ForestRupicolous/ESP32-WorkTimeTracker/gehaeuse/vorschau.png

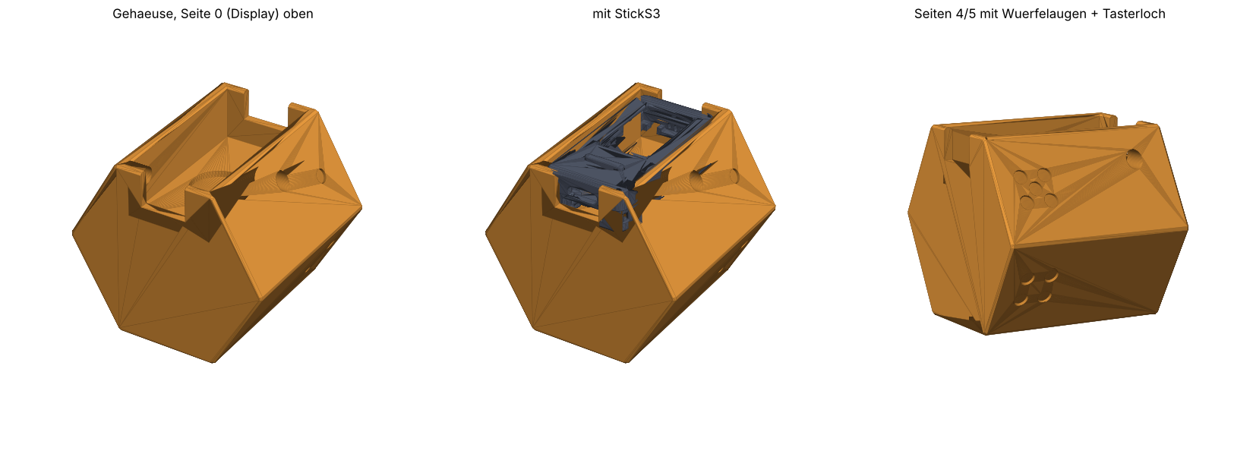
gehaeuse/vorschau.png
