ForestRupicolous/ESP32-WorkTimeTracker/gehaeuse/vorschau_muenze8.png

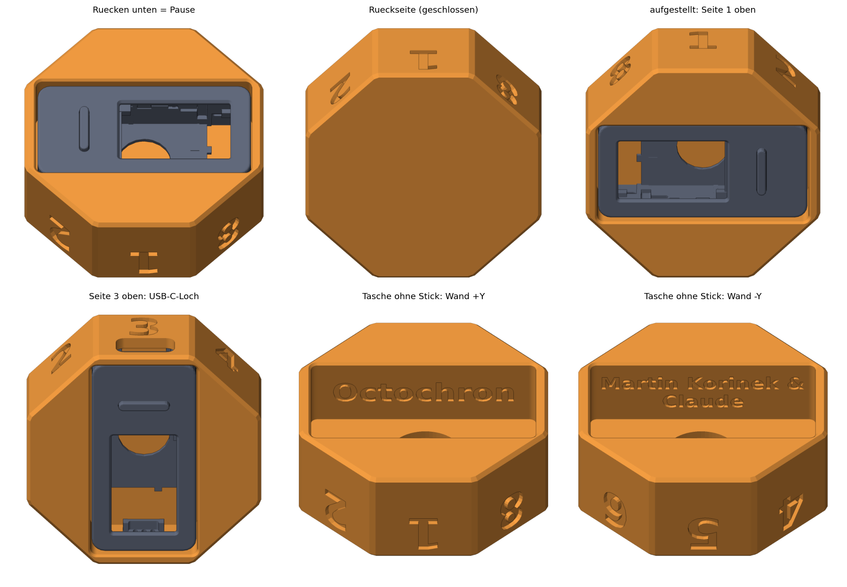
gehaeuse/vorschau_muenze8.png
