ForestRupicolous/ESP32-WorkTimeTracker/gehaeuse/zeitprisma_muenze8_22mm_usb.stl

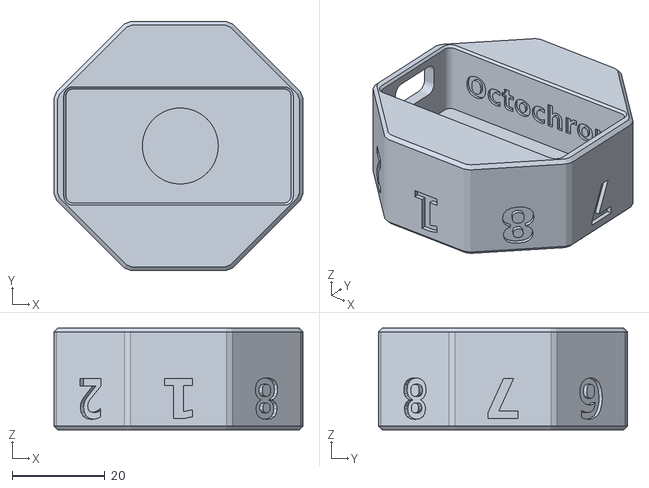
[picture p3: CAD file, 2026-10-29]
gehaeuse/zeitprisma_muenze8_22mm_usb.stl
53.8 x 53.8 x 22.0
