ForestRupicolous/ESP32-WorkTimeTracker/gehaeuse/zeitprisma_gehaeuse.stl

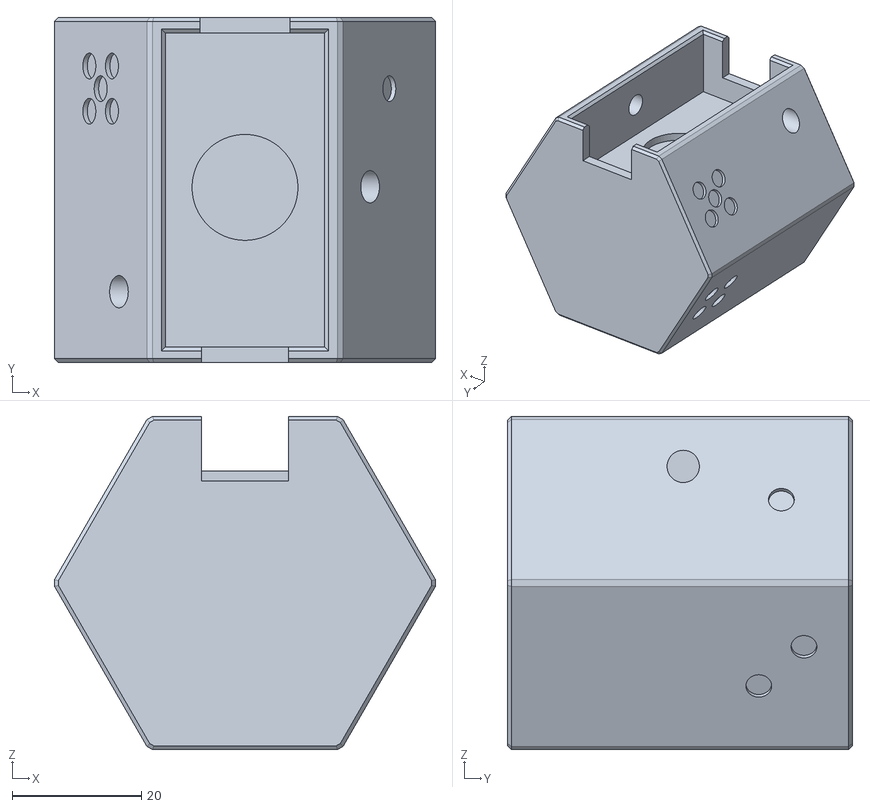
[picture p4: CAD file, 2026-10-16]
gehaeuse/zeitprisma_gehaeuse.stl
59.0 x 53.4 x 51.6
