ForestRupicolous/ESP32-WorkTimeTracker/(commit log)

2026-10-16 Add Zeitprisma firmware, enclosure and evaluation tool
    Imported from the M5StickC S3 Projektzeitschreiber chat: PlatformIO
    firmware (M5Unified, M5PM1) with host tests, parametric hex prism
    enclosure (STL + generator script) and CSV evaluation script.
2026-10-29 Integrate zeitprisma update: 8-sided coin, multi-variant firmware
    - Add 8-sided coin enclosure (muenze_gehaeuse.py, STL, preview) as the
    default; prisma_gehaeuse.py is now a 10-sided prism with lid
    - Firmware: build variants via PlatformIO envs muenze8 (default),
    muenze12 and prisma10; display rotation, beep sequence, two-column
    status screen
    - Host tests cover all three variants (130/188/140 checks)
    - Add CLAUDE.md, Makefile and tools/seriallog.py; merge README and
    .gitignore
    Fixes on top of the zip:
    - make build now builds all three envs (it built only the default env)
    - enclosure scripts use CrossSection(..., FillRule.EvenOdd), because
    CrossSection.even_odd does not exist in ma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
2026-10-29 Remove obsolete hexagon prism files
    zeitprisma_gehaeuse.stl and vorschau.png belong to the former six-sided
    prism (5 projects). No script or firmware env produces or uses them any
    more; they remain in history (a231673). Update README and CLAUDE.md.
2026-10-29 Recognise sides without dead zone, with hysteresis and faster switching
    Replace the capture-range classification in operation by classifyRing():
    while the stick stands roughly in the rotation axis (acceleration within
    35 degrees of the ring plane, 45 to leave) the nearest edge side is
    always returned, measured as the angle inside the ring plane. A
    hysteresis of 0.2 * step angle stops flicker at the side borders; entry
    and exit of the ring plane and of side 0 (coin on its back) have their
    own hysteresis. Outside that the position is unknown = pause.
    Switch faster: still window 25 -> 10 samples (0.5 -> 0.2 s), settle time
    3000 -> 600 ms, so a new side is taken about 0.8 s after the stick stop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
2026-10-29 Record measurements of the new recognition and the wake loop
    README and CLAUDE.md: first reading of the new side recognition on the
    device (first change 0.85 s after sampling began, teach-in model kept)
    and the wake loop seen with the stick idle on the desk: after going to
    sleep the motion wake fires again after about 0.6 s, three times, then
    the 60 s timer fallback takes over. Likely the same cause as the restart
    loop before flashing, not ModemManager. Cause still open.
2026-10-29 Fix wake loop: map only any-motion to BMI270 INT1, wait for a quiet IRQ line
    The stick woke again about 0.6 s after going to deep sleep. Measured on
    the device with the new WAKE_DIAG switch: after M5.begin() the BMI270
    register INT_MAP_DATA reads 0xFF, which maps data-ready, FIFO and error
    interrupts to INT1 and INT2. INT1 therefore pulsed with every sample
    (50 Hz), the M5PM1 latched the edges and held G13 low.
    - bmiArmAnyMotion(): write INT_MAP_DATA, INT2_MAP_FEAT, INT2_IO_CTRL = 0
    - waitIrqQuiet(): stay awake, clear the IRQ on every trigger and sleep
    only after G13 was high for IRQ_QUIET_MS (300 ms), at most 2.5 s, else
    the 60 s timer fallback as before
    - WAKE_DIAG (default 0): log th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
2026-10-29 Record device results: wake by motion works, no loop, side changes while rolling
    README and CLAUDE.md: 200 s capture of the final WAKE_DIAG 0 build on the
    StickS3, stick rolled by hand without the enclosure. 24 side changes
    (1, 3, 5, 6, 7, 8 and pause), none unknown. Motion woke the stick four
    times and it slept 84 s untouched without a single wake, so the loop is
    gone. First change after a wake 1.6 to 2.4 s after chip start, about
    0.8 s of that is boot. Sensitivity and behaviour in a bag or in the
    enclosure are still to be tuned.
2026-10-29 Shorten boot and settle time: skip M5 IMU init on warm wake, 0.4 s detection
    - STILL_WINDOW 10 -> 6 (0.12 s), SETTLE_MS 600 -> 250: a new side is taken
    about 0.4 s after the stick comes to rest (was 0.8 s).
    - Warm wake from deep sleep: M5.begin() runs with internal_imu = false and hal
    reads the BMI270 itself (axes {y, -x, z} like M5Unified). Only allowed after
    imuSelfCheck() matched M5.Imu on an earlier start (RTC flag imuFastOk); falls
    back to the M5 init if the BMI270 is not initialised.
    - The start line now carries the boot timings (setup@ begin ui hal store imu=).
    Measured on the device (200 s capture, rolled by hand): start line 0.57 s after
    chip start (was 0.80 s), first side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
2026-10-29 Longer display, button wake shows the status, one soft tone per project, teach-in log
    - Project confirmation stays 5 s (PROJECT_SHOW_MS, was 2.5 s); status 8 s
    (STATUS_SHOW_MS).
    - wokeByButton() required the button to still be pressed at boot (about 0.6 s
    after the press), so a normal click woke the stick but kept the display off.
    EXT1/GPIO wake cause is enough now.
    - Tones: 8 different single tones (C major pentatonic, table PROJECT_TONES_HZ,
    pause = lowest note) instead of long/short sequences. Generated in ui.cpp
    (sine + soft octave, attack/decay) and played with Speaker.playRaw, started in
    the background while the display is drawn; commit() waits for the end.
    - Serial log lin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
2026-10-29 Add shake detector and day log helpers to prisma_core (host-tested)
    - ShakeDetector: counts peaks of the change between consecutive samples; four
    peaks of more than 0.25 g within one second count as a shake. Single bumps,
    slow rolling, turning and noise stay below it; a gap between samples is
    ignored.
    - dayLogPath() and localMidnight() for one log file per local day.
    - Host tests for all three variants: 262 / 352 / 281 checks, all green.
    Mutation check: threshold 0.04 g, one peak or a 3 s window each make tests fail.
2026-10-29 Record the teach-in run on the device, avoid exists() on the new day file
    Device run (13:11): flash, NVS backup and erase, watchdog reset. Cold start
    without model, teach-in completed with a maximum deviation of 6.0 degrees, model
    saved, first day file written on the first side change. The speaker pre-start
    takes 5 ms.
    store: decide "new file" from the size after opening for append instead of
    exists(), which logged an error for the missing day file. Built, not flashed.
2026-10-29 Record the user's device results: tones, display, shake, button
    Reported by the user after the flash with re-teach (no log): tones are good,
    the tone after waking from lying into a project now comes, the 5 s project
    screen with the accumulated time is fine, shaking while lying shows the
    overview, a short click on button A shows it from deep sleep. Not checked: day
    log contents and export, project names from config_local.h, long button presses,
    power, teach-in with the enclosure.
2026-10-29 Export: send /log.csv with Content-Length, record the fetched data
    Fetched from the device over Wi-Fi (single days and the HTTP/1.0 download are
    correct, tools/auswertung.py processes them); the HTTP/1.1 chunked download of
    /log.csv arrived malformed (curl error 56) or stalled after the first block.
    /log.csv now sends an exact Content-Length (store::streamAllSize) and writes to
    the client directly, like streamFile does for single days. Built, not flashed.
2026-10-29 Enclosure: deeper digits, no dot on the 6, renumbered, text inside, closed back
    - Digits engraved 1.0 mm instead of 0.6 mm; the depth is limited to what the wall
    allows (2.6 mm end wall at sides 3 and 7 keeps 1.6 mm, WALL_MIN). The 12-sided
    variant stays at 0.6 mm.
    - No dot after the 6.
    - Numbering rotated: the side that carried the 4 now carries the 1 (-Y side),
    counting continues as before; the USB side is now 3 (was 6).
    - Text engraved into the two long pocket walls (0.6 mm): "Octochron" and two
    lines of author names; visible only without the stick.
    - Push-out hole in the back removed (option --ausdrueckloch brings it back).
    - New gehaeuse/vorschau_muenze.py (numpy z-buffer render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
2026-10-29 Record that the enclosure interpretations were confirmed
    "Deeper" means deeper engraved, and the numbering is a pure rotation (the former
    4 is now the 1, counting direction unchanged).
2026-10-29 Record the device check of the fixed export
    After flashing the Content-Length version, /log.csv over HTTP/1.1 arrived
    complete 3 of 3 times (12887 bytes, identical, header + old file without header
    + day file without header, the earlier day state is a prefix). 24 more requests of
    all four addresses returned 200 in 0.08 to 0.36 s; one curl timeout on a single-day
    request was not reproducible.
2026-10-29 Note that the WLAN export via button A (2 s hold) works
    Triggered twice by the user on 29.10.2026, the stick was reachable over Wi-Fi
    afterwards. Only the 6 s hold (teach-in by button) is still untested.
2026-10-29 Rewrite the README: usage guide first, status and details below
    - New "Anleitung" section at the top: principle, setup, daily use, button A,
    data export, what happens in the background, what is confirmed.
    - The status boxes become the section "Stand der Pruefung" (restrictions first).
    - The short firmware summary is folded into the guide; the detailed section is
    now "Funktionsweise im Detail".
    - Corrected stale statements: host test counts (262/352/281), project screen
    (5 s, with the day time), log files per day, the teach-in model survives
    flashing, a by-hand teach-in worked once (6.0 deg).
    - Added the open point that the RTC accuracy in deep sleep is not measured.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
2026-10-29 Split the README: user guide first, project part second, no history
    - Part 1 is an operating guide without project info: principle, first start
    and teach-in, daily use, button A, data export, charging, troubleshooting,
    known limits. No enclosure status, no constants, no flashing.
    - Part 2 holds the project: variants, enclosure, settings, flashing, status of
    the checks, technical detail, troubleshooting, power, open points.
    - History is gone from the README (before/after notes, bug stories, session
    logs, earlier versions, project lineage, the removed hexagon). It stays in
    git and in CLAUDE.md.
    - The enclosure is printed and works according to the user; recorded in the
    status secti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
2026-10-29 Record the printed enclosure and the README structure in CLAUDE.md
    - The enclosure is printed and works according to the user; the headline
    status, the 3D-model note, next step 7 and the open point on removing the
    stick now say so. Details (fit, magnet hold, plug, tipping, removal without
    the push-out hole) were not given and stay unmarked.
    - The headline status listed the day-log content and export as untested
    although the export was fetched and checked; corrected.
    - New convention "README-Aufbau": part 1 is a user guide without project info,
    part 2 is the project, no history in the README (chronicle stays here and in
    git). Pointer to the README sections updated.
    Co-Authored-By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
2026-11-03 Run the time sync in a background task so the stick keeps counting
    Scan, connect and NTP ran in the main loop and stopped the stick for 10 to 20 s.
    Now net::syncStart() runs them in a task, pollSync() takes over the clock as soon
    as SNTP has set it, nowT() keeps counting time since boot until then. The
    no-clock log gets its restart line only once counting without a clock starts.
    Checked on the device: changes keep being recognised while the sync runs, the
    log without a clock and the day log fit together.
